PolyEd/MicroMouse/README.md

Hello! This is the central readme for the PolyEd MicroMouse Project. \
This file is a compilation of general (non-code specific) information relating to the project.

Our inspiration: \
[The Fastest Maze-Solving Competition On Earth](https://www.youtube.com/watch?v=ZMQbHMgK2rw)

The conference we will attend: \
[APEC](https://apec-conf.org/)

Rules:
- [The conference rules](https://s3.us-east-1.amazonaws.com/apec-conf-images/APEC_Policies_And_Procedures_Rev_7-3_2022-09-02.pdf) —\
  See page 15 "Minimum Age Policy" which implies there is no minimum age for the MicroMouse contest.
- [An old set of MicroMouse rules (revision 2009)](http://micromouseusa.com/wp-content/uploads/2013/10/APEC-Rules.pdf)

**Important** files to read before working with the Arduino code or using it:
- [I2C README](I2C-README.md)
- [Info about the plotting library used in this project](PLOTTER-README.md)

<!--
---
Also [Nim](https://nim-lang.org/) 😃
--><!--I (Joshua) commented this out to not be beligerent, please leave it in here in this form though, just for fun-->
