PolyEd/MicroMouse/VL53L0X/README.md

The VL53L0X is a time-of-flight distance sensor using [I2C](../I2C-README.md). The library is available from the Library Manager as "VL53L0X" (by Polulu).

## Pins:
Arduino    | VL53L0X
-----------|--------
  GND      | GND
  5V       | VIN
  SCL/A5/3 | SCL
  SDA/A4/2 | SDA

The example code is available in VL53L0X.ino

The code in VL53L0X_plotter is a testing program using the [plotting library](../PLOTTER-README.md).
