PolyEd/MicroMouse/Arduino Uno Rev3/README.MD

# Info about the Arduino Uno Rev3

\# Official start of the project! (9/14/23)
