PolyEd/MicroMouse/Encoder Motor/Screenshot 2026-10-12 at 11.39.05 AM.png

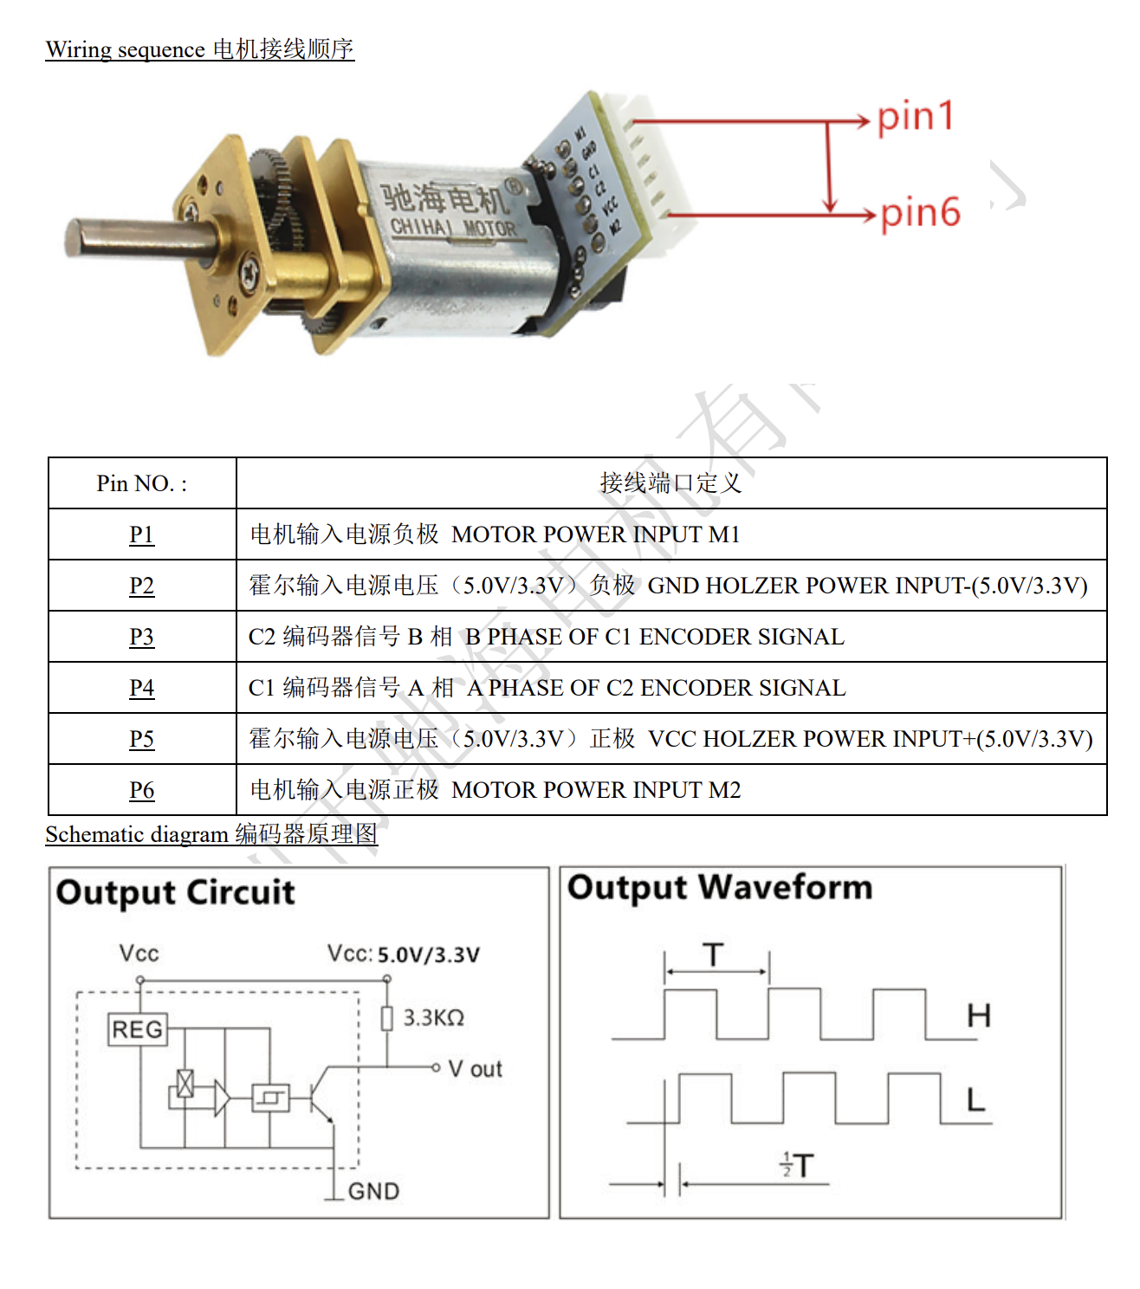
Encoder Motor/Screenshot 2026-10-12 at 11.39.05 AM.png
