PolyEd/MicroMouse/Micromouse2/Micromouse.step

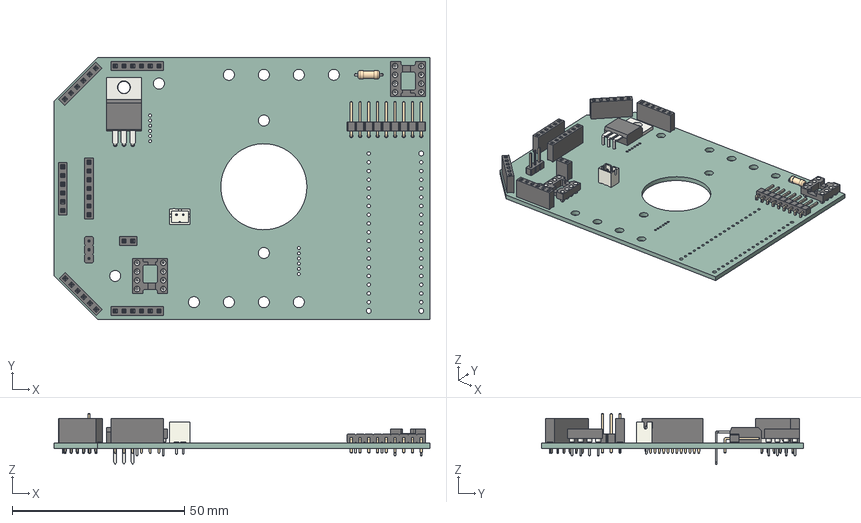
[picture p2: CAD file, 2026-10-16]
Micromouse2/Micromouse.step
109.2 x 76.2 x 14.9 mm
JST_B2B_PH_K
PinSocket_1x06_P254mm_Vertical x 5
TO-220-3_Horizontal_TabDown
PinSocket_1x07_P254mm_Vertical
PinHeader_1x09_P254mm_Horizontal
PinSocket_1x02_P254mm_Vertical
R_Axial_DIN0207_L63mm_D25mm_P762mm_Horizontal
DIP_8_W762mm_Socket x 2
PinHeader_1x03_P254mm_Vertical
Micromouse PCB
