PolyEd/MicroMouse/Micromouse2026PCB/Micromouse2026PCB.kicad_pcb

## KiCad design Micromouse2026PCB/Micromouse2026PCB.kicad_pcb (2026-10-29)

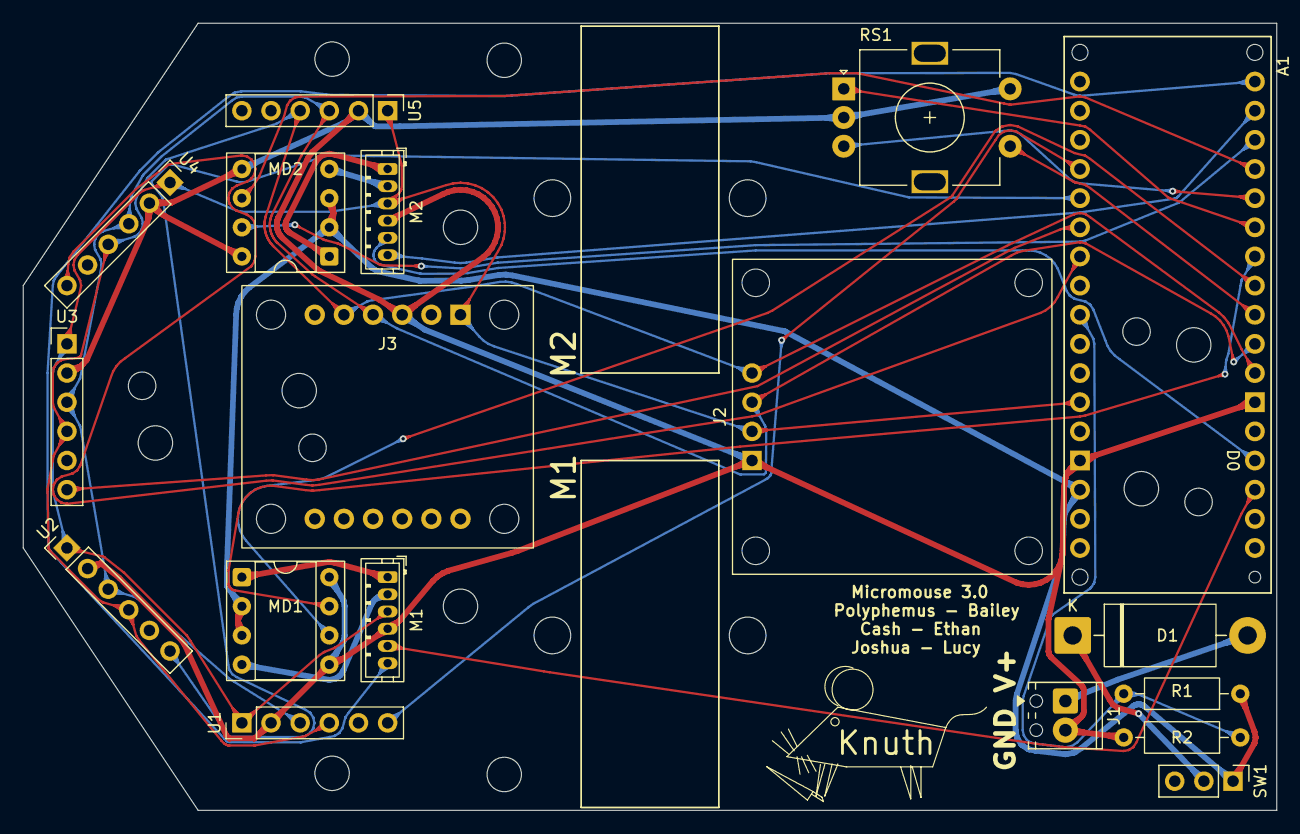
[picture p3: board Micromouse2026PCB.kicad_pcb from above]

Board: 2 copper layers, 109.2 x 68.6 mm, 18 parts (0 on the bottom side), 27 nets.

Parts:
A1: Arduino_Micro_Socket
D1: 1N5822; D_DO-201AD_P15.24mm_Horizontal
J1: Power Terminal; TerminalBlock_Phoenix_MPT-0,5-2-2.54_1x02_P2.54mm_Horizontal
J2: i2c OLED; OLED_0.96_SSD1306_I2C
J3: BNO085; Adafruit_BNO085
M1, M2: JST_ZH_B6B-ZR_1x06_P1.50mm_Vertical
MD1, MD2: DIP-8_W7.62mm_Socket
R1, R2: 10k; R_Axial_DIN0207_L6.3mm_D2.5mm_P10.16mm_Horizontal
RS1: RotaryEncoder_Switch; RotaryEncoder_Alps_EC11E-Switch_Vertical_H20mm
SW1: PowerSW; PinHeader_1x03_P2.54mm_Vertical
U1, U2, U3, U4, U5: PinHeader_1x06_P2.54mm_Vertical

Connections:
+5V: A1.5V, J2.2, J3.1, M1.3 (VCC), M2.3 (VCC), U1.1 (VIN), U2.1 (VIN), U3.1 (VIN), U4.1 (VIN), U5.1 (VIN)
/SCL: A1.D3 (D3/SCL), J2.3, J3.4, U1.3 (SCL), U2.3 (SCL), U3.3 (SCL), U4.3 (SCL), U5.3 (SCL)
/SDA: A1.D2 (D2/SDA), J2.4, J3.5, U1.4 (SDA), U2.4 (SDA), U3.4 (SDA), U4.4 (SDA), U5.4 (SDA)
GND: A1.GND1 (GND), A1.GND2 (GND), J1.2, J2.1, J3.3, M1.4 (GND), M2.4 (GND), MD1.5 (GND), MD1.8 (GND), MD2.5 (GND), MD2.8 (GND), R2.2, RS1.C, RS1.S2, U1.2 (GND), U2.2 (GND), U3.2 (GND), U4.2 (GND), U5.2 (GND)
unnamed: A1.D0 (D0/RX), M2.5 (OA)
unnamed: A1.D1 (D1/TX), M1.5 (OA)
unnamed: A1.D7 (D7_INT4), RS1.A
unnamed: A1.A5, R1.2, R2.1
unnamed: A1.D4, RS1.S1
unnamed: A1.D8, RS1.B
unnamed: D1.2 (A), J1.1
unnamed: D1.1 (K), SW1.2
unnamed: M1.1 (MA), MD1.1 (OA)
unnamed: M1.2 (MB), MD1.4 (OB)
unnamed: A1.D12, M1.6 (OB)
unnamed: M2.1 (MA), MD2.1 (OA)
unnamed: M2.2 (MB), MD2.4 (OB)
unnamed: A1.D11, M2.6 (OB)
unnamed: A1.D5, MD1.6 (IA)
unnamed: A1.D6, MD1.7 (IB)
unnamed: A1.D9, MD2.6 (IA)
unnamed: A1.D10, MD2.7 (IB)
unnamed: A1.VIN, MD1.2 (VCC), MD1.3 (VCC), MD2.2 (VCC), MD2.3 (VCC), R1.1, SW1.1
unnamed: A1.A0, U1.6 (XSHUT)
unnamed: A1.A1, U2.6 (XSHUT)
unnamed: A1.A2, U3.6 (XSHUT)
unnamed: A1.A3, U4.6 (XSHUT)
