PolyEd/MicroMouse/Micromouse2/Micromouse.kicad_pcb

## KiCad design Micromouse2/Micromouse.kicad_pcb (2026-10-16)

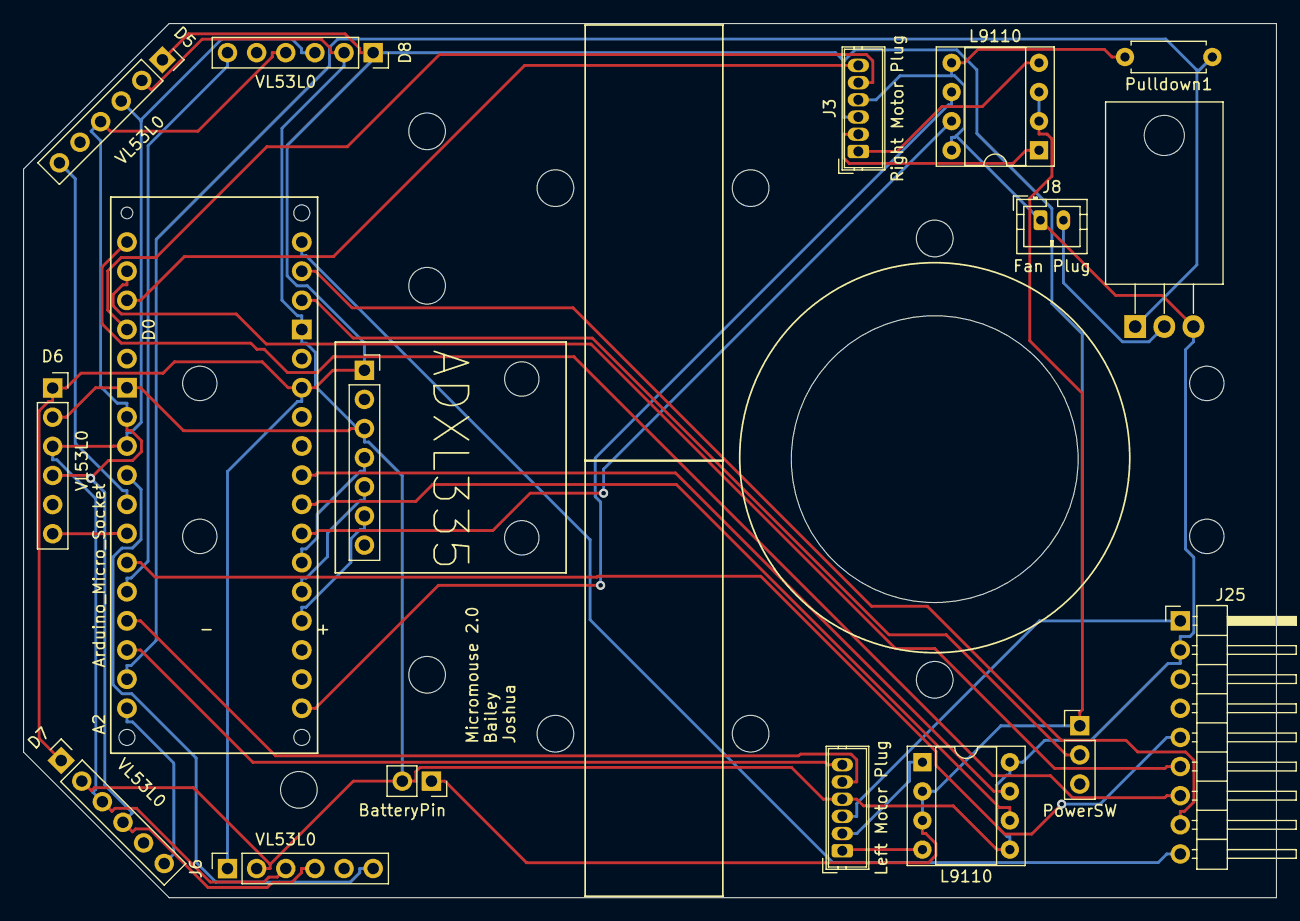
[picture p4: board Micromouse.kicad_pcb from above]

Board: 2 copper layers, 109.2 x 76.2 mm, 17 parts (0 on the bottom side), 33 nets.

Parts:
A2: Arduino_Micro_Socket
D5, D6, D7, D8: VL53L0; PinSocket_1x06_P2.54mm_Vertical
J1: BatteryPin; PinSocket_1x02_P2.54mm_Vertical
J2: Left Motor Plug; Wuerth_WR-WTB_64800611622_1x06_P1.50mm_Vertical
J3: Right Motor Plug; Wuerth_WR-WTB_64800611622_1x06_P1.50mm_Vertical
J6: VL53L0; PinSocket_1x06_P2.54mm_Vertical
J7: ADXL335; PinSocket_1x07_P2.54mm_Vertical
J8: Fan Plug; JST_PH_B2B-PH-K_1x02_P2.00mm_Vertical
J9: PowerSW; PinHeader_1x03_P2.54mm_Vertical
J25: Conn_01x09_Socket; PinHeader_1x09_P2.54mm_Horizontal
Pulldown1: 1K; R_Axial_DIN0207_L6.3mm_D2.5mm_P7.62mm_Horizontal
Q1: IRFZ44N; TO-220-3_Horizontal_TabDown
U1, U2: L9110; DIP-8_W7.62mm_Socket

Connections:
5V Arduino: A2.5V, D5.1 (Vin), D6.1 (Vin), D7.1 (Vin), D8.1 (Vin), J2.3, J3.3, J6.1 (Vin), J7.1, J25.1
Battery-7v: J1.1, J9.1, U1.2 (VCC), U1.3 (VCC), U2.2 (VCC), U2.3 (VCC)
FAN: A2.D11, Pulldown1.1, Q1.1 (G)
GND: A2.GND1 (GND), A2.GND2 (GND), D5.2 (GND), D6.2 (GND), D7.2 (GND), D8.2 (GND), J1.2, J2.4, J3.4, J6.2 (GND), J7.3, J8.1, J25.2, Pulldown1.2, Q1.3 (S), U1.5 (GND), U1.8 (GND), U2.5 (GND), U2.8 (GND)
Hall-effect1: A2.D0 (D0/RX), J3.5
Hall-effect2: A2.D1 (D1/TX), J3.6
unnamed: A2.D7 (D7_INT4), J25.5
unnamed: A2.SS (SPI_CS), J25.6
unnamed: A2.MISO (SPI_MISO), J25.8
unnamed: A2.MOSI (SPI_MOSI), J25.7
unnamed: A2.SCK (SPI_SCK), J25.9
unnamed: A2.D5, D5.6 (XSHUT)
unnamed: A2.D6, D6.6 (XSHUT)
unnamed: A2.D12, D7.6 (XSHUT)
unnamed: A2.D8, D8.6 (XSHUT)
unnamed: J2.1, U1.4 (OB)
unnamed: J2.2, U1.1 (OA)
unnamed: A2.D9, J2.5
unnamed: A2.D10, J2.6
unnamed: J3.1, U2.4 (OB)
unnamed: J3.2, U2.1 (OA)
unnamed: A2.D4, J6.6 (XSHUT)
unnamed: A2.A2, J7.4
unnamed: A2.A1, J7.5
unnamed: A2.A0, J7.6
unnamed: J8.2, Q1.2 (D)
unnamed: A2.VIN, J9.2
SCL: A2.D3 (D3/SCL), D5.3 (SCL), D6.3 (SCL), D7.3 (SCL), D8.3 (SCL), J6.3 (SCL)
SDA: A2.D2 (D2/SDA), D5.4 (SDA), D6.4 (SDA), D7.4 (SDA), D8.4 (SDA), J6.4 (SDA)
m1.1: A2.A5, U1.7 (IB)
m1.2: A2.A4, U1.6 (IA)
m2.1: A2.A3, U2.7 (IB)
m2.2: A2.D13, U2.6 (IA)
