PolyEd/MicroMouse/(OLD) File Structure/Eagle Files/Micromouse Eagle Project/pcb.brd

## EAGLE design (OLD) File Structure/Eagle Files/Micromouse Eagle Project/pcb.brd (2024-02-09, an earlier design)

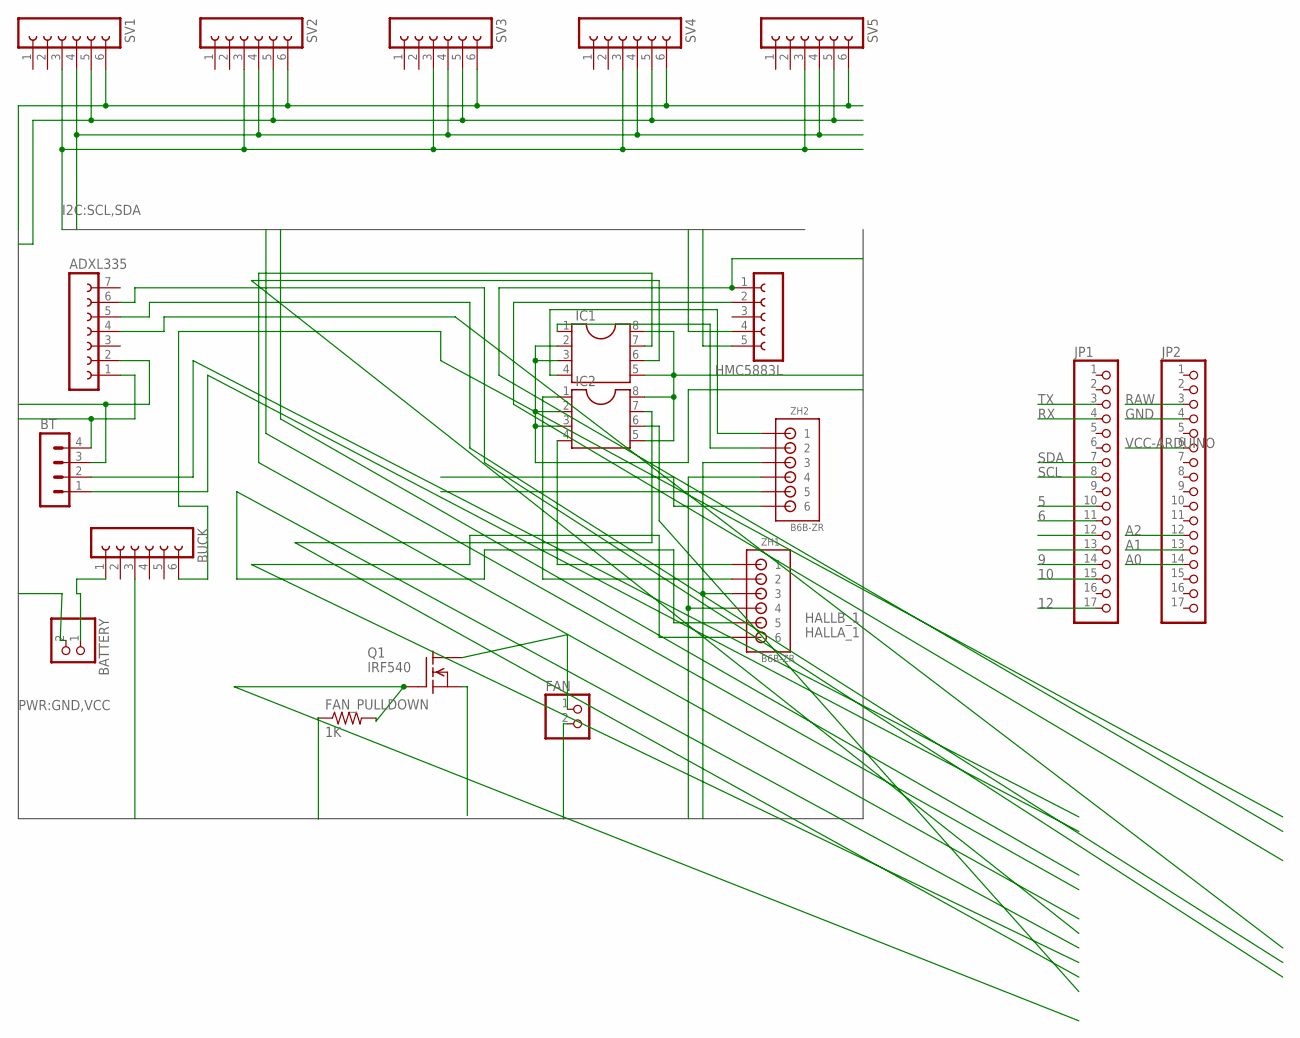
[picture p5: schematic pcb.sch]

Parts:
ADXL335: FE07-1; FE07
BATTERY: PINHD-1X2; 1X02
BT: MA04-1
BUCK: FE06-1; FE06
FAN: PINHD-1X2; 1X02
FAN_PULLDOWN: 1K; 0207/10
HMC5883L: FE05-1
IC1, IC2: DIL8S; SOCKET-08
JP1, JP2: PINHD-1X17; 1X17
Q1: IRF540; TO220
SV1, SV2, SV3, SV4, SV5: FE06-1; FE06
ZH1, ZH2: B6B-ZR

Connections:
5: IC1.7, JP1.10
6: IC1.6, JP1.11
9: IC2.7, JP1.14
10: IC2.6, JP1.15
12: FAN_PULLDOWN.2, JP1.17, Q1.1 (G)
A0: ADXL335.6, JP2.14
A1: ADXL335.5, JP2.13
A2: ADXL335.4, JP2.12
GND: ADXL335.2, BATTERY.2, BT.3, BUCK.3, FAN_PULLDOWN.1, HMC5883L.1, IC1.5, IC1.8, IC2.5, IC2.8, JP2.4, Q1.3 (S), SV1.5, SV2.5, SV3.5, SV4.5, SV5.5, ZH1.4, ZH2.4
HALLA_1: JP1.13, ZH1.6
HALLB_1: JP1.12, ZH1.5
unnamed: BATTERY.1, BUCK.1
unnamed: IC1.1, ZH2.2
unnamed: IC1.4, ZH2.1
unnamed: IC2.4, ZH1.1
unnamed: IC2.1, ZH1.2
unnamed: FAN.1, Q1.2 (D)
RAW: BUCK.6, JP2.3
RX: BT.1, JP1.4
SCL: HMC5883L.4, JP1.8, SV1.4, SV2.4, SV3.4, SV4.4, SV5.4
SDA: HMC5883L.5, JP1.7, SV1.3, SV2.3, SV3.3, SV4.3, SV5.3
TX: BT.2, JP1.3
VCC: ADXL335.1, BT.4, FAN.2, IC1.2, IC1.3, IC2.2, IC2.3, SV1.6, SV2.6, SV3.6, SV4.6, SV5.6, ZH1.3, ZH2.3
VCC-ARDUINO: HMC5883L.2, JP2.6

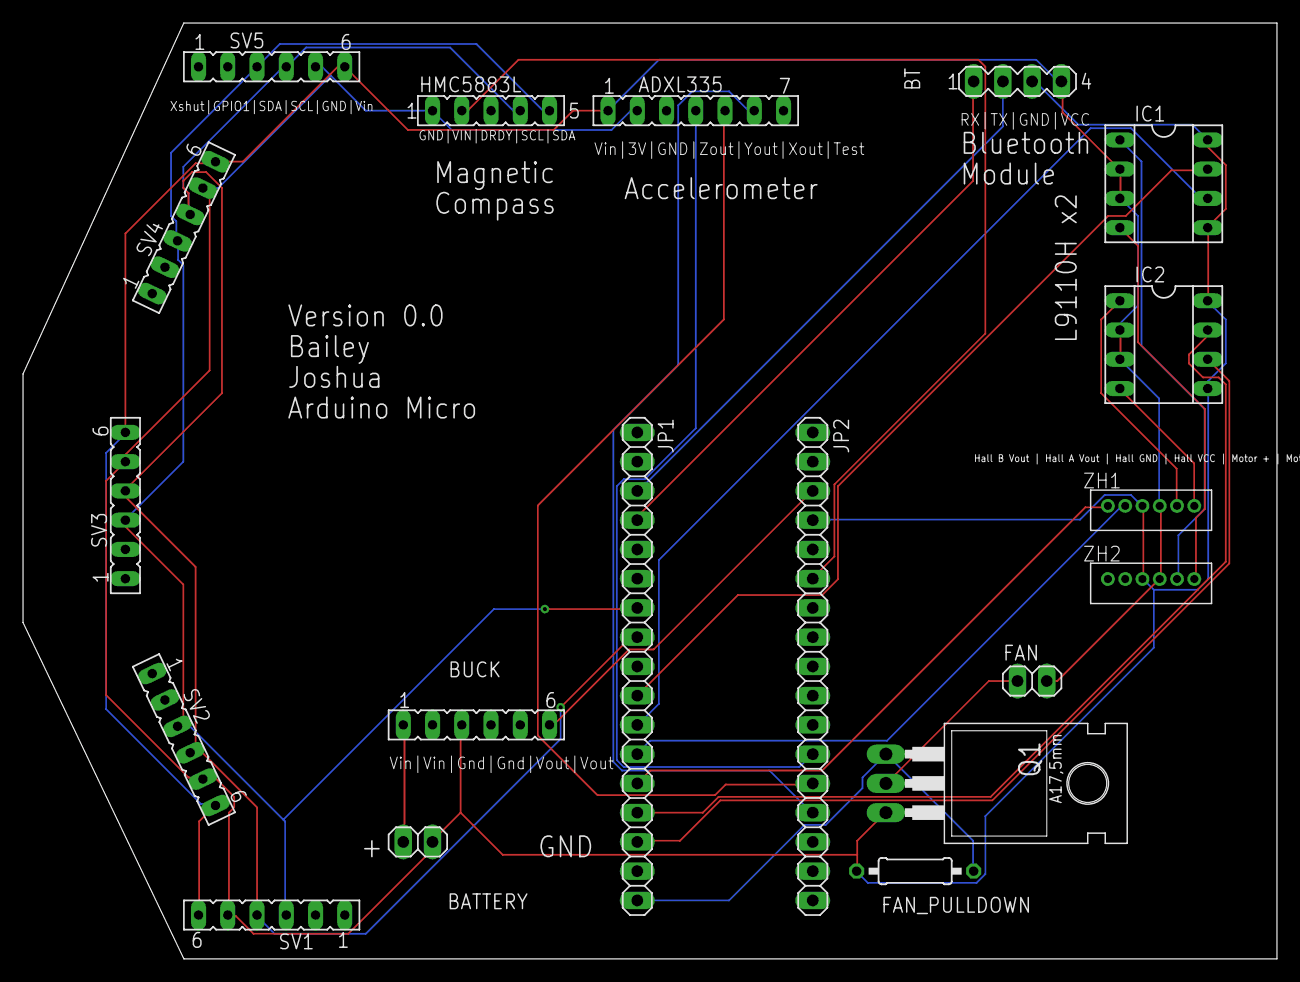
[picture p6: board pcb.brd from above]

Board: 2 copper layers, 108.9 x 81.3 mm, 19 parts (0 on the bottom side), 24 nets.
