PolyEd/MicroMouse/(commit log)

2023-09-14 Create Arduino Uno Rev3 folder
2023-09-14 Add eagle files + schematics + other info
2023-10-11 Added info on I2C, plotting, and the VL53L0X.
2023-10-26 Add N20 Gear Motor Connector Eagle File
2024-01-20 Update Eagle Design
    [pcb.brd, pcb.sch]
2024-02-09 added labels
    [pcb.brd]
2025-01-17 Reorganize file structure
    [pcb.brd, pcb.sch, pegs-scale-maze.scad]
2025-04-24 Add Disambiguation for some code and fix bug in microsuite noble
    [microsuite_noble.ino]
2025-05-29 add straight code (current version)
2026-09-17 added kicad
    kicad current
2026-09-17 Add BLE to straight_code and fix logic issues
    [straight_code.ino]
2026-10-12 Adafruit encoder motor docs
2026-10-14 Claude Code encoder library + example code for adafruit n20 motor
2026-10-15 made new pcb file
2026-10-15 started pcb work and custom symbols
2026-10-15 worked on PCB
2026-10-16 New PCB work
2026-10-16 finished schematic
2026-10-16 PCB work
2026-10-16 PCB working version
2026-10-22 Encoder motor fix
2026-10-23 PCB done
